rrayy-25809/DAC-for-minimoog/MiniControl_v1.1_Schematic.pdf

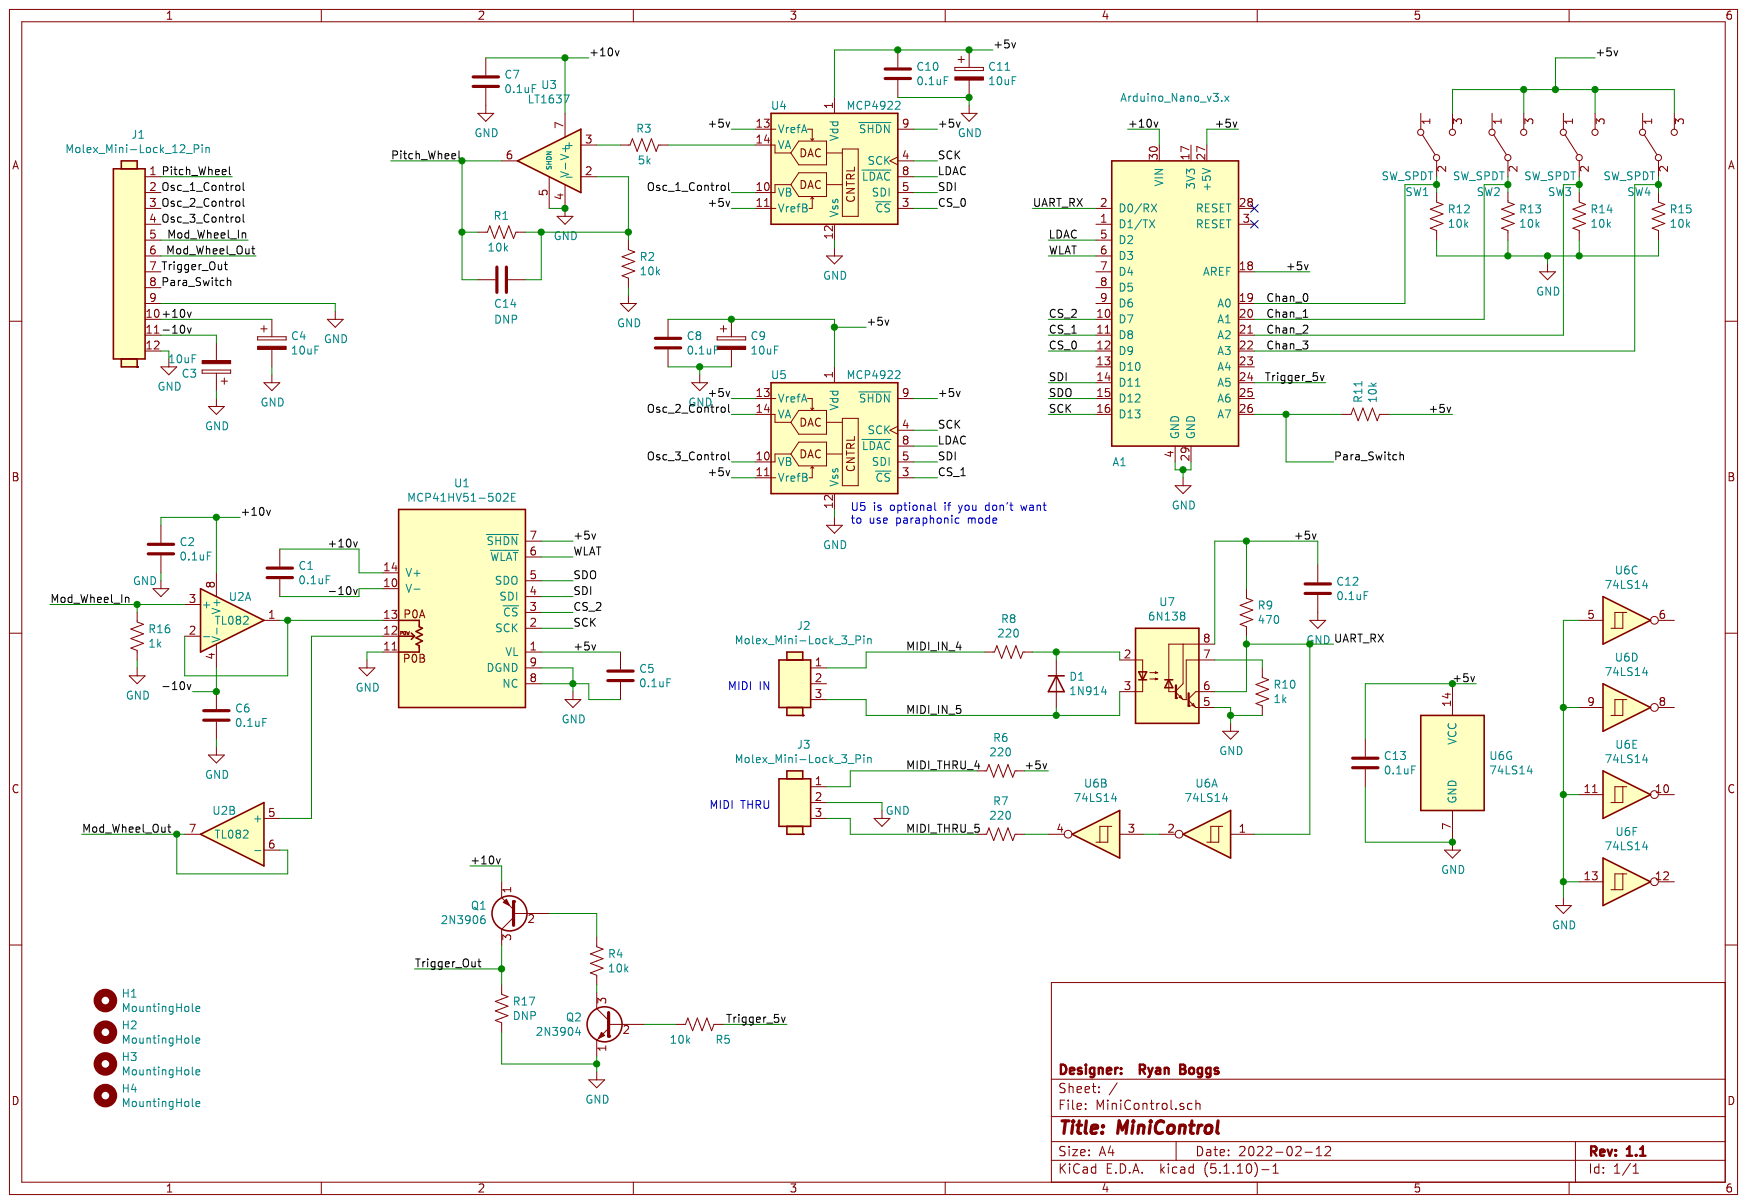
[picture p1: page 1]
