rrayy-25809/DAC-for-minimoog/MiniControl_PBC_v1.1/MiniControl.kicad_pcb

## KiCad design MiniControl_PBC_v1.1/MiniControl.kicad_pcb (2025-04-19)

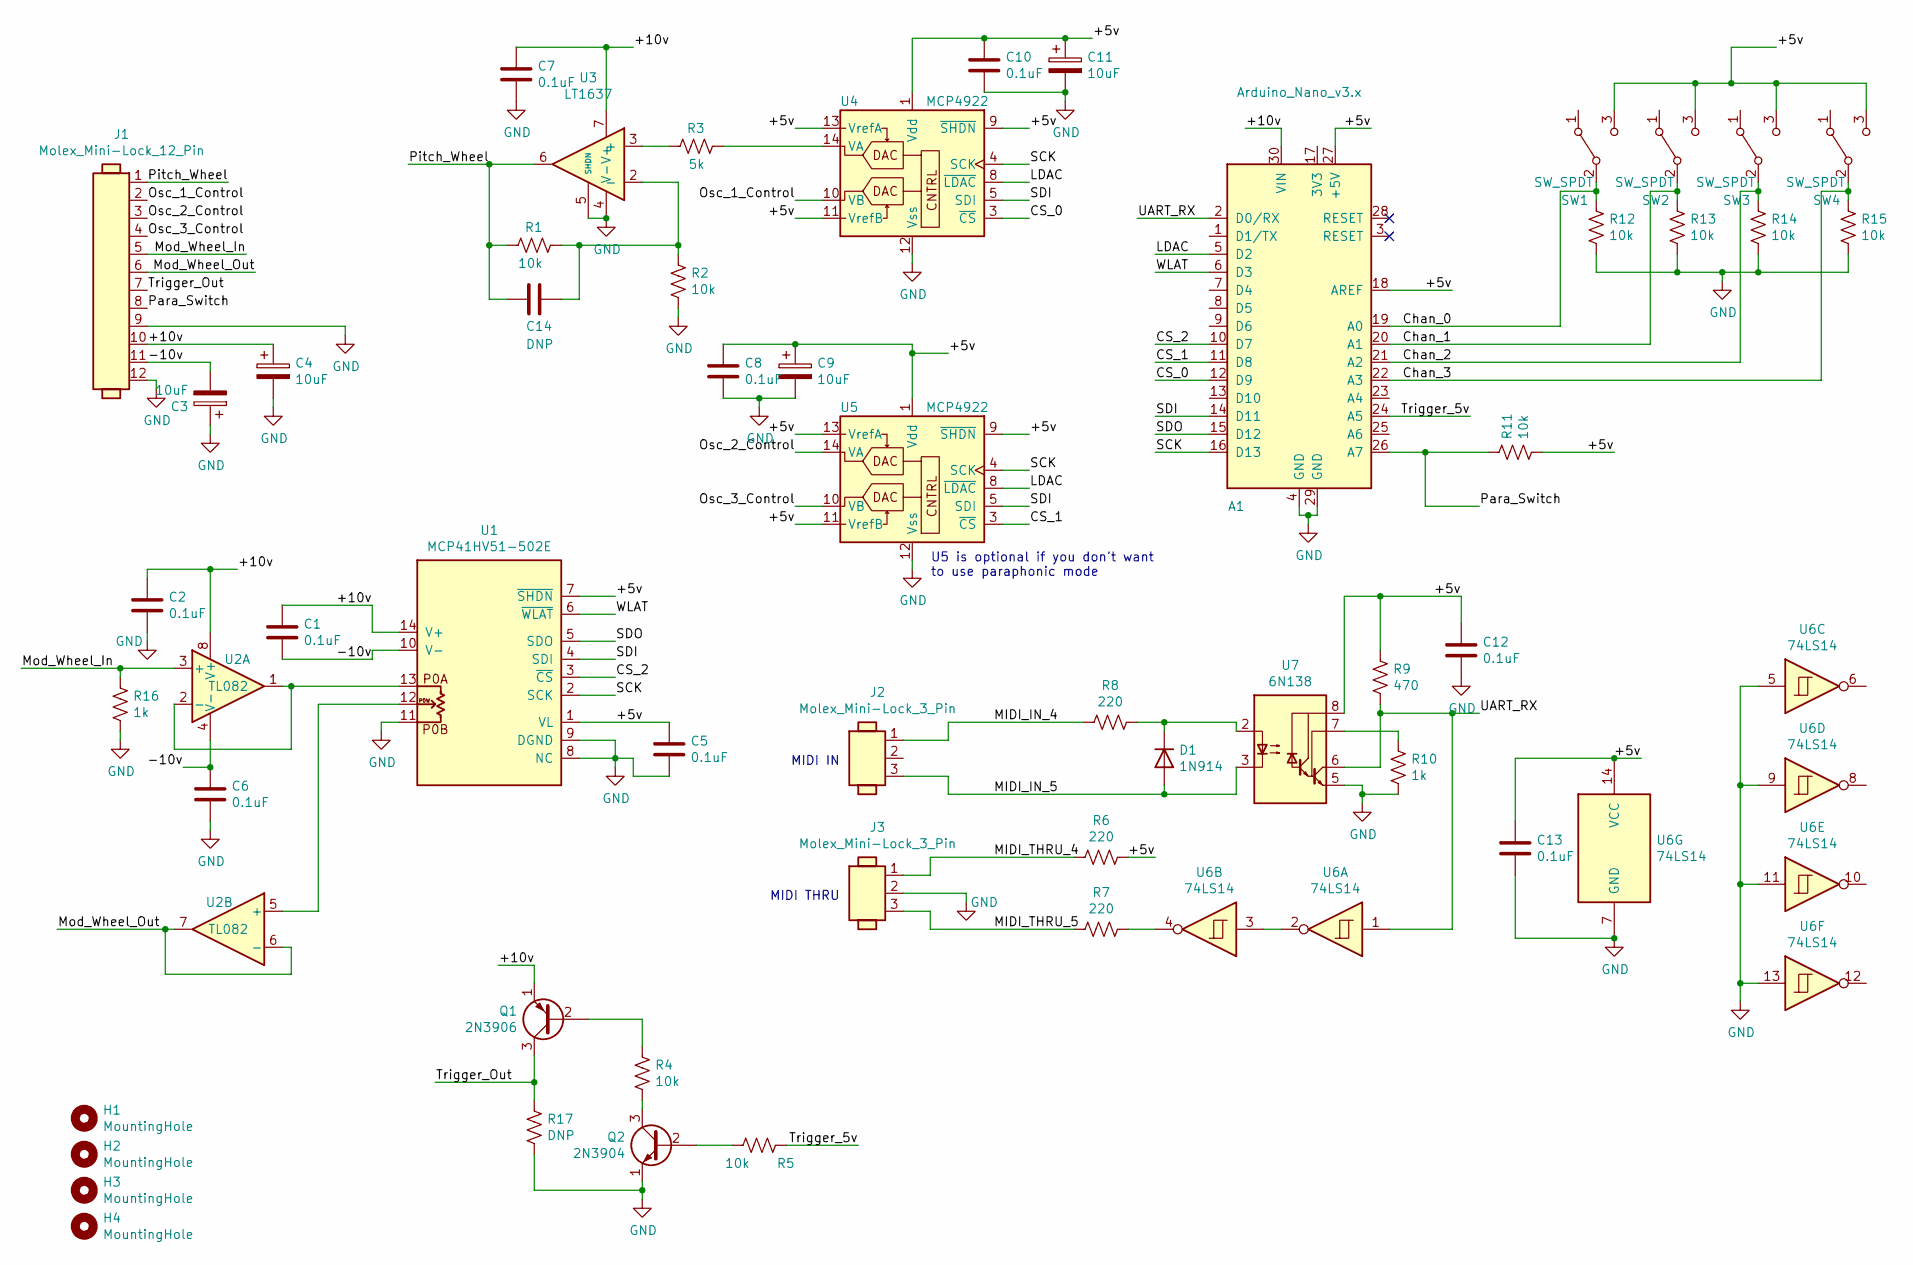
[picture p2: schematic MiniControl.sch]

Parts:
A1: Arduino_Nano_v3.x; Arduino_Nano
C1, C2, C5, C6, C7, C8, C10, C12, C13: 0.1uF; C_Disc_D5.1mm_W3.2mm_P5.00mm
C3, C4, C9, C11: 10uF; CP_Radial_Tantal_D6.0mm_P5.00mm
C14: DNP; C_Disc_D5.1mm_W3.2mm_P5.00mm
D1: 1N914; D_DO-35_SOD27_P7.62mm_Horizontal
H1, H2, H3, H4: MountingHole; MountingHole_3.2mm_M3
J1: Molex_Mini-Lock_12_Pin; Molex_Mini-Lock_0534261210_1x12_P2.50mm_Horizontal; Part # 0534261210
J2, J3: Molex_Mini-Lock_3_Pin; Molex_Mini-Lock_0534260310_1x03_P2.50mm_Horizontal; Part # 0534260310
Q1: 2N3906; TO-92_Inline
Q2: 2N3904; TO-92_Inline
R1, R2, R4, R5, R11, R12, R13, R14, R15: 10k; R_Axial_DIN0207_L6.3mm_D2.5mm_P10.16mm_Horizontal
R3: 5k; R_Axial_DIN0207_L6.3mm_D2.5mm_P10.16mm_Horizontal
R6, R7, R8: 220; R_Axial_DIN0207_L6.3mm_D2.5mm_P10.16mm_Horizontal
R9: 470; R_Axial_DIN0207_L6.3mm_D2.5mm_P10.16mm_Horizontal
R10, R16: 1k; R_Axial_DIN0207_L6.3mm_D2.5mm_P10.16mm_Horizontal
R17: DNP; R_Axial_DIN0207_L6.3mm_D2.5mm_P10.16mm_Horizontal
SW1, SW2, SW3, SW4: SW_SPDT; SW_Slide_SPDT_EG1218
U1: MCP41HV51-502E; TSSOP-14_4.4x5mm_P0.65mm
U2: TL082; DIP-8_W7.62mm_Socket
U3: LT1637; DIP-8_W7.62mm_Socket
U4, U5: MCP4922; DIP-14_W7.62mm_Socket
U6: 74LS14; DIP-14_W7.62mm_Socket
U7: 6N138; DIP-8_W7.62mm_Socket

Connections:
/+5v: A1.18 (AREF), A1.27 (+5V), C5.1, C8.1, C9.1, C10.1, C11.1, C12.1, C13.1, R6.2, R9.1, R11.2, SW1.3 (C), SW2.3 (C), SW3.3 (C), SW4.3 (C), U1.1 (VL), U1.7 (~SHDN), U4.1 (Vdd), U4.9 (~SHDN), U4.11 (VrefB), U4.13 (VrefA), U5.1 (Vdd), U5.9 (~SHDN), U5.11 (VrefB), U5.13 (VrefA), U6.14 (VCC), U7.8 (VCC)
/+10v: A1.30 (VIN), C1.1, C2.1, C4.1, C7.1, J1.10, Q1.1 (E), U1.14 (V+), U2.8 (V+), U3.7 (V+)
/-10v: C1.2, C3.2, C6.1, J1.11, U1.10 (V-), U2.4 (V-)
/CS_0: A1.12 (D9), U4.3 (~CS)
/CS_1: A1.11 (D8), U5.3 (~CS)
/CS_2: A1.10 (D7), U1.3 (~CS)
/CS_3: A1.9 (D6)
/Chan_0: A1.19 (A0), R12.1, SW1.2 (B)
/Chan_1: A1.20 (A1), R13.1, SW2.2 (B)
/Chan_2: A1.21 (A2), R14.1, SW3.2 (B)
/Chan_3: A1.22 (A3), R15.1, SW4.2 (B)
/LDAC: A1.5 (D2), U4.8 (~LDAC), U5.8 (~LDAC)
/MIDI_IN_4: J2.1, R8.1
/MIDI_IN_5: D1.2 (A), J2.3, U7.3 (C2)
/MIDI_THRU_4: J3.1, R6.1
/MIDI_THRU_5: J3.3, R7.1
/Mod_Wheel_In: J1.5, R16.1, U2.3 (+)
/Mod_Wheel_Out: J1.6, U2.6 (-), U2.7
/Osc_1_Control: J1.2, U4.10 (VB)
/Osc_2_Control: J1.3, U5.14 (VA)
/Osc_3_Control: J1.4, U5.10 (VB)
/Para_Switch: A1.26 (A7), J1.8, R11.1
/Pitch_Wheel: C14.2, J1.1, R1.1, U3.6
/SCK: A1.16 (D13), U1.2 (SCK), U4.4 (SCK), U5.4 (SCK)
/SDI: A1.14 (D11), U1.4 (SDI), U4.5 (SDI), U5.5 (SDI)
/SDO: A1.15 (D12), U1.5 (SDO)
/Trigger_5v: A1.24 (A5), R5.2
/Trigger_Out: J1.7, Q1.3 (C), R17.1
/UART_RX: A1.2 (D0/RX), R9.2, U6.1, U7.6 (VO2)
/WLAT: A1.6 (D3), U1.6 (~WLAT)
GND: A1.4 (GND), A1.29 (GND), C2.2, C3.1, C4.2, C5.2, C6.2, C7.2, C8.2, C9.2, C10.2, C11.2, C12.2, C13.2, J1.9, J1.12, J3.2, Q2.1 (E), R2.2, R10.2, R12.2, R13.2, R14.2, R15.2, R16.2, R17.2, U1.8 (NC), U1.9 (DGND), U1.11, U3.4 (V-), U3.5 (NC), U4.12 (Vss), U5.12 (Vss), U6.5, U6.7 (GND), U6.9, U6.11, U6.13, U7.5 (GND)
unnamed: C14.1, R1.2, R2.1, U3.2 (-)
unnamed: D1.1 (K), R8.2, U7.2 (C1)
unnamed: Q1.2 (B), R4.1
unnamed: Q2.2 (B), R5.1
unnamed: Q2.3 (C), R4.2
unnamed: R3.1, U3.3 (+)
unnamed: R3.2, U4.14 (VA)
unnamed: R7.2, U6.4
unnamed: R10.1, U7.7 (VO1)
unnamed: U1.12, U2.5 (+)
unnamed: U1.13, U2.1, U2.2 (-)
unnamed: U6.2, U6.3

Notes on the sheet:
MIDI IN
MIDI THRU
U5 is optional if you don't want to use paraphonic mode

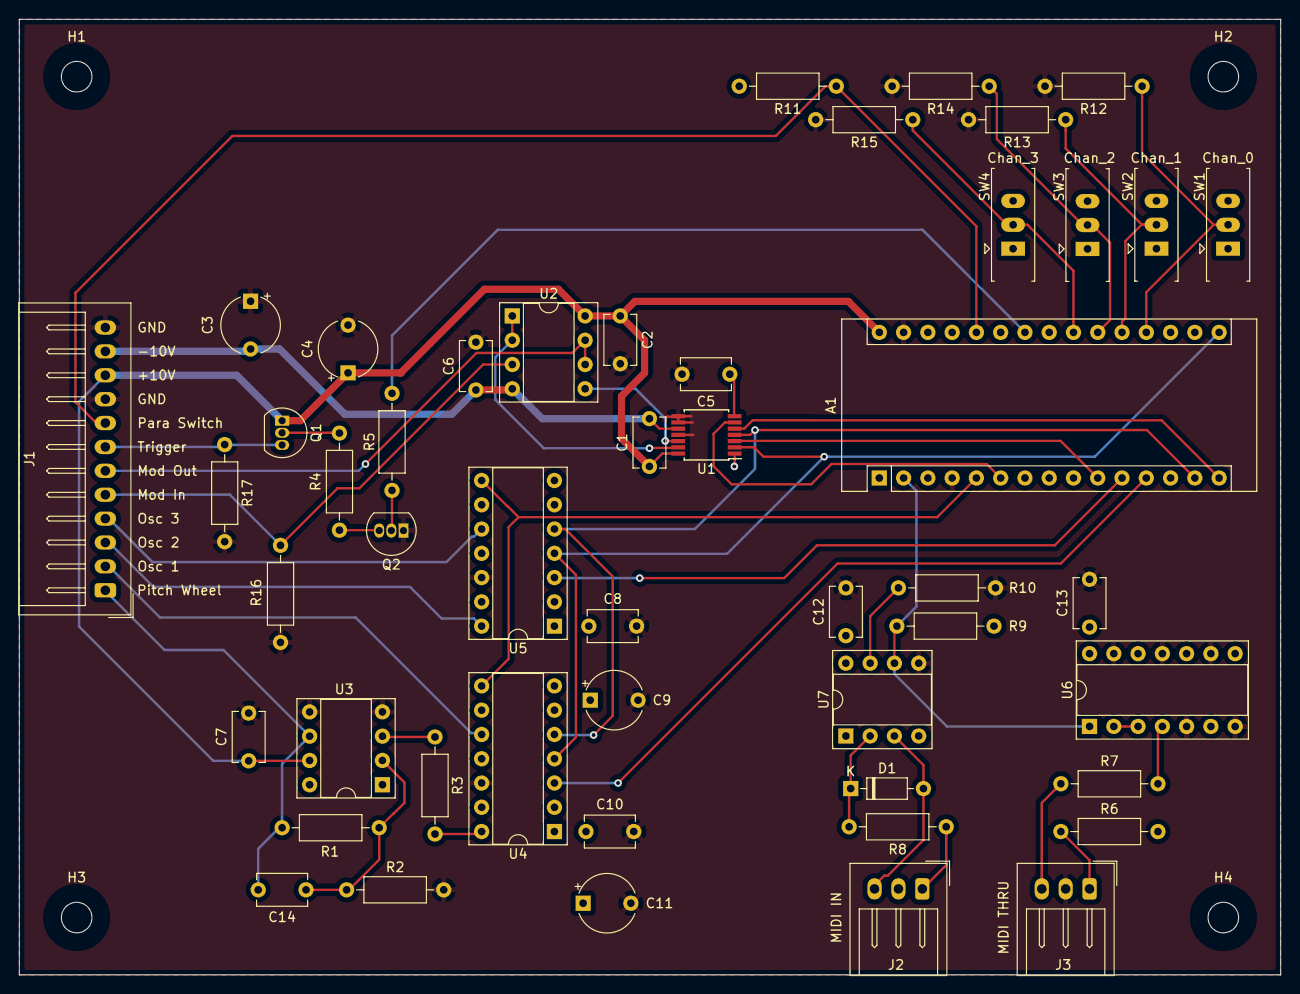
[picture p3: board MiniControl.kicad_pcb from above]

Board: 2 copper layers, 132.0 x 100.0 mm, 53 parts (0 on the bottom side), 42 nets.
