rrayy-25809/DAC-for-minimoog/(commit log)

2025-04-23 Changes to be committed: platformio 사용 new file: .gitignore new file: .vscode/extensions.json new file: platformio.ini renamed: DAC.ino -> src/DAC.ino
2025-05-11 Changes to be committed: platformio 못 써먹겠음;; new file: .vscode/arduino.json deleted: .vscode/extensions.json new file: .vscode/settings.json renamed: src/DAC.ino -> DAC.ino deleted: platformio.ini
2025-06-24 Changes to be committed: 최적의 설정 찾아내는 중 modified: .vscode/arduino.json modified: .vscode/settings.json modified: DAC.ino
2025-07-26 Changes to be committed: noteList 해더 파일 설치, 아두이노 라이브러리 설정 실패 modified: .gitignore modified: .vscode/arduino.json new file: .vscode/c_cpp_properties.json modified: .vscode/settings.json new file: note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
2025-07-26 Changes to be committed: 미디 라이브러리 VScode에 적용 성공 modified: .vscode/c_cpp_properties.json
